schda1/tt10-moody-mimosa/docs/figs/Mimosa_model_v1.0.png

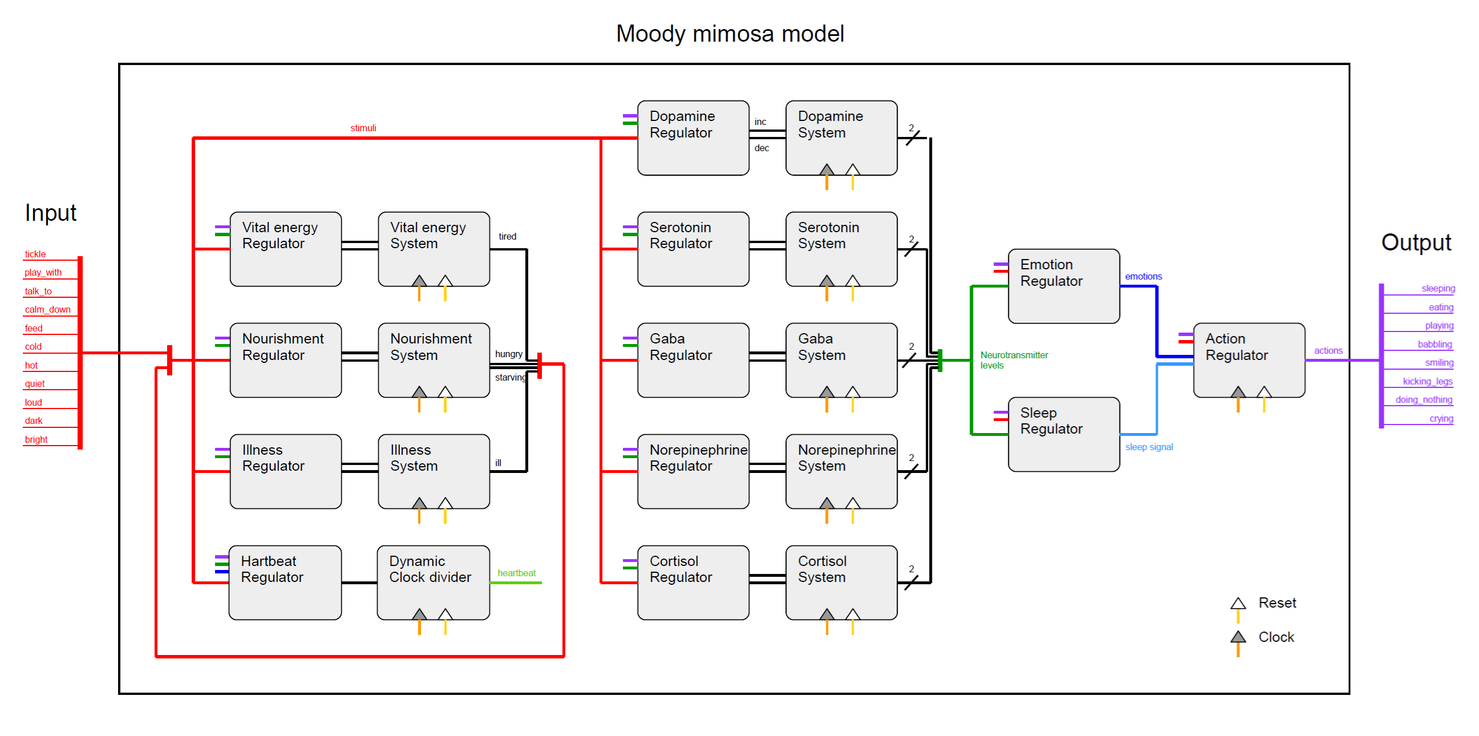
docs/figs/Mimosa_model_v1.0.png
