schda1/tt10-moody-mimosa/src/neurotransmitter/gaba_system.v

`default_nettype none
`ifndef PY_SIM
/* verilator lint_off UNUSEDSIGNAL */
`endif

module gaba_system (
    input wire clk,
    input wire rst_n,
    input wire [9:0] neurotransmitter_level,
    input wire [7:0] emotional_state,
    input wire [15:0] stimuli,
    input wire [7:0] action,
    output wire [1:0] gaba_level
    `ifdef PY_SIM
    , output wire [6:0] dbg_gaba
    `endif
);

    wire inc, dec, fast, setval;
    wire [6:0] gaba;

    assign setval = 0;

    /* Regulator for the gaba level */
    gaba_regulator gaba_regulator (
        .neurotransmitter_level(neurotransmitter_level),
        .emotional_state(emotional_state),
        .stimuli(stimuli),
        .action(action),
        .inc(inc),
        .dec(dec),
        .fast(fast)
    );

    /* gaba resource */
    resource #(
        .N(7),
        .SET_VAL(64),
        .DEFAULT_VAL(96),
        .FAST_STEP(3)
    ) gaba_resource (
        .clk(clk),
        .rst_n(rst_n),
        .inc(inc),
        .dec(dec),
        .fast(fast),
        .setval(setval),
        .value(gaba)
    );

    /* gaba level, downscaled (2-bit) */
    assign gaba_level = gaba[6:5];

    `ifdef PY_SIM
    assign dbg_gaba = gaba;
    `endif

endmodule
