schda1/tt10-moody-mimosa/src/neurotransmitter/serotonin_system.v

`default_nettype none
`ifndef PY_SIM
/* verilator lint_off UNUSEDSIGNAL */
`endif

module serotonin_system (
    input wire clk,
    input wire rst_n,
    input wire [9:0] neurotransmitter_level,
    input wire [7:0] emotional_state,
    input wire [15:0] stimuli,
    input wire [7:0] action,
    output wire [1:0] serotonin_level
    `ifdef PY_SIM
    , output wire [6:0] dbg_serotonin
    `endif
);

    wire inc, dec, fast, setval;
    wire [6:0] serotonin;

    assign setval = 0;

    /* Regulator for the serotonin level */
    serotonin_regulator serotonin_regulator (
         .neurotransmitter_level(neurotransmitter_level),
        .emotional_state(emotional_state),
        .stimuli(stimuli),
        .action(action),
        .inc(inc),
        .dec(dec),
        .fast(fast)
    );

    /* Serotonin resource */
    resource #(
        .N(7),
        .SET_VAL(64),
        .DEFAULT_VAL(96),
        .FAST_STEP(3)
    ) serotonin_resource (
        .clk(clk),
        .rst_n(rst_n),
        .inc(inc),
        .dec(dec),
        .fast(fast),
        .setval(setval),
        .value(serotonin)
    );

    /* Serotonin level, downscaled (2-bit) */
    assign serotonin_level = serotonin[6:5];

    `ifdef PY_SIM
    assign dbg_serotonin = serotonin;
    `endif

endmodule
