schda1/tt10-moody-mimosa/module_test/stress_regulator/tb_stress_regulator.v

`default_nettype none
`timescale 1ns / 1ps

module tb_stress_regulator ();

  // Dump the signals to a VCD file
  initial begin
    $dumpfile("tb_stress_regulator.vcd");
    $dumpvars(0, tb_stress_regulator);
    #1;
  end

  // Wire up the inputs and outputs:
  reg state_controller_inc;
  reg state_controller_dec;
  reg [6:0] stimuli;
  wire stress_inc;
  wire stress_dec;

  // Instantiate stess_regulator classifier module 
  stress_regulator dut (
      .state_controller_inc (state_controller_inc),   
      .state_controller_dec (state_controller_dec),
      .stimuli (stimuli),
      .stress_inc (stress_inc),
      .stress_dec (stress_dec)
  );

endmodule
