schda1/tt10-moody-mimosa/(commit log)

2024-12-06 Basic setup for alchitry Au fpga board
    Ported example project and set up tcl
    script. Tested on alchitry Au board.
2024-12-06 Inverted heartbeat logic
    Since the heartbeat will be fed into
    the dynamic clock divider module,
    a lower heartbeat corresponds to
    a higher clock division value.
    [tb_heartbeat_model.v, test_heartbeat_model.py]
2024-12-07 Added minimal sleep cycle application
    Moody mimosa module will be top
    module for ASCI and FPGA. Currently,
    it changes between sleeping (low energy)
    and being awake (high energy).
2024-12-07 Added alchitry wrapper and updated xdc
    Possible to implement the moody
    mimosa on the Alchitry Au FPGA
    target using the IO-pins of the
    Alchitry Io board (leds, buttons,
    switches). The pins are mapped
    in the xdc file and the fpga wrapper
    au_moody_mimosa module also
    creates a ~1Hz clock that would
    otherwise be provided by input
    pin 0.
2024-12-07 Added energy regulator and test
2024-12-07 Added stress regulator and test
    Minimal implementation. Loops through
    the sleep controller command if stimulus
    1 is not set. Otherwise, stress will be
    incremented.
2024-12-07 Added minimal pleasure regulator and test
2024-12-07 Attached emotional encoding to mimosa
    Based on resources (energy,
    stress and pleasure), the emotional
    state is calculated. This is basically
    a truth table. Each resource
    combination is mapped to a
    single emotional state and
    this mapping was optimized
    using pyeda and the espresso
    logic optimizer.
2024-12-07 Added additional debug port to fpga
    The alchitry Io board has 24
    on-board leds. For debugging,
    I want to access all of them and
    thus add this port optionally
    (ifdef) to the mimosa module.
2024-12-07 Attached heartbeat model and clock divider
    Clock divider slows down clock depending on
    the actual emotional and physical state.
2024-12-07 Fixed bug in emotional model
    [tb_emotional_model.v, test_emotional_model.py]
2024-12-07 Fixed minor issues
    Output updated. Output enbled
    set (although not relevant for fpga).
    Fixed minor issues in harden script.
    [moody_mimosa.v]
2024-12-08 Fixed minor bugs and extended documentation
    renamed moody_mimosa to tt_um_moody_mimosa.
    Will be required by verilator to work properly.
    Updated readme, gitignore and info.yaml.
    [tt_um_moody_mimosa.v]
2024-12-21 Added vital energy system
    Vital energy models the degree of
    tiredness. After having slept, you have
    a lot of vital energy. If you don't sleep,
    it goes down.
2024-12-21 Added emotions
    Emotions are not modelled by a state
    machine but just a combinational
    mapping between neurotransmitter
    levels and emotion type.
    Supported emotions are happy,
    excited, bored, angry, stressed,
    nervous, apathetic and calm.
    Tired, hungry and starving are
    not modelled as emotions. They
    are internal stimuli, deriving
    from the nourishment and
    vital energy level.
2024-12-21 Added actions (FSM)
    Actions are modelled as a state machine.
    The mimosa can act in 8 ways: Sleep, eat,
    play, smile, babble, kick legs, doing nothing
    or cry. Depending on external or internal
    stimuli, emotional states, vital energy level
    or the desire to sleep or wake up, state
    transitions take place.
2024-12-21 Added logger application for stm32 mcu
    A stm32g474 is used as a co-processor. It is
    responsible for the clock signal and for
    logging all in- and outputs and sending
    it via uart to the host computer.
    Main idea: It is a deterministic system and
    the input is sufficient to simulate the
    behaviour with the PyVerilator simulation.
    Therefore, the entire simulation can be
    run in parallel and we get insight into
    the mimosa (information that is otherwise
    hidden in the ASIC) and can understand
    why it behaves the way it behaves.
    For this we need the full input at
    defined times (e.g. between the
    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
2024-12-21 Fixed failing fpga build
    Recursively searches src folder after having
    rearranged files in different folders.
    Following design change: Clock is provided
    on the clk pin and not a separate pin.
    [au_moody_mimosa.v]
2024-12-22 Added pwm handler and unit tests
    I decided to define the comparator
    comparison voltages with the on-board
    microcontroller. I probably want to
    change the definitions of 'cold' or
    'dark' and therefore, it is useful to
    set it with uart commands.
    The STM32G474RE mcu does not
    have 6 independent DAC channels.
    Therefore, I use pwm-signals fed
    through a RC low pass filter to define
    the comparator levels.
2024-12-23 Added parameter handler and default flash storage
    Allows to synchronize parameters with an external
    storage medium (download, upload). This allows
    changing parameters such as e.g. thresholds for
    cold, hot etc. via UART and persistently store
    them on some medium (Flash, FRAM, EEPROM).
2025-01-02 Removed C modules in order to switch to C++
    Decided to set up a C++ application, as an experiment.
2025-01-02 Added minimalistic timer wrappers
    Minimal wrapper classes for timers. They
    are minimal, this whole project is a personal
    exerpiment.
2025-01-02 Added minimalistic uart wrapper
    Minimal wrapper classes for uart. They
    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
2025-01-02 Added minimalistic SPI wrapper
    Minimal wrapper classes for SPI.
2025-01-02 Added storage classes
    Implemented SPI FRAM storage and storage
    in internal flash
2025-01-02 Added PwmHandler and ComparatorDriver
    Used to control various pwm outputs with a
    single timer (in software). Used for defining the
    comparator comparison levels, with a low-pass
    RC-filter.
2025-01-02 Added PinObserver
    Allows to read out the mimosa pins (input and
    outputs) and reports them via UART.
2025-01-02 Added basic talking feature
    Mimosa reads data with SPI from an
    external FRAM and sends it via UART.
    Missing: Depending on emotions and
    development stage, it retrieves data
    at different locations in FRAM.
    [counter_with_pulse.v, remember_and_talk.v]
2025-01-05 Added speech planner and module test
    Speech planner figures out at which FRAM
    address the appropriate phrase needs to
    be read. The address depends on emotion,
    specific actions and the development stage.
    The phrase consists of 24 bytes and for each
    scneario, there are two phrase variants stored
    in FRAM
2025-01-05 Added LcdDisplay with I2C
    Messages from the ASIC are displayed on a
    standard 16x2 Lcd display with I2C expander.
2025-01-05 Extended main application and cleaned up
    Basic setup of the main application (added
    all peripherals and all main functionality,
    including 19200 Hz clock for the ASIC,
    Exti interrupt for the mimosa, 2x uart,
    1xI2C for the display, 1xSPI for the
    Lcd Display etc.
